FStilwell/0_Flicker_Fusion_Threshold/Eagle Files/Flicker_Fusion_schematic-white.PNG

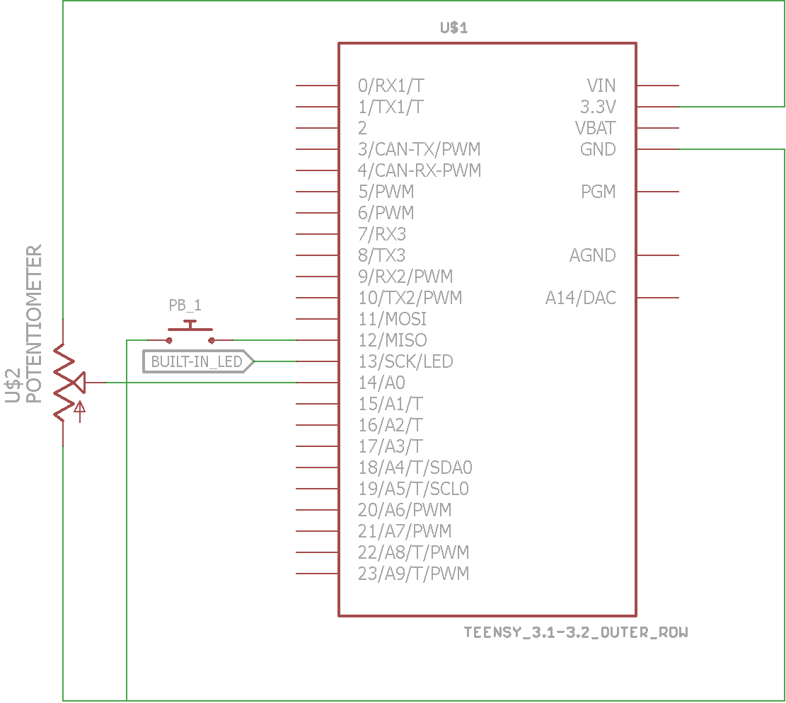
Eagle Files/Flicker_Fusion_schematic-white.PNG
