FStilwell/0_Flicker_Fusion_Threshold/Eagle Files/Flicker_Fusion_schematic.PNG

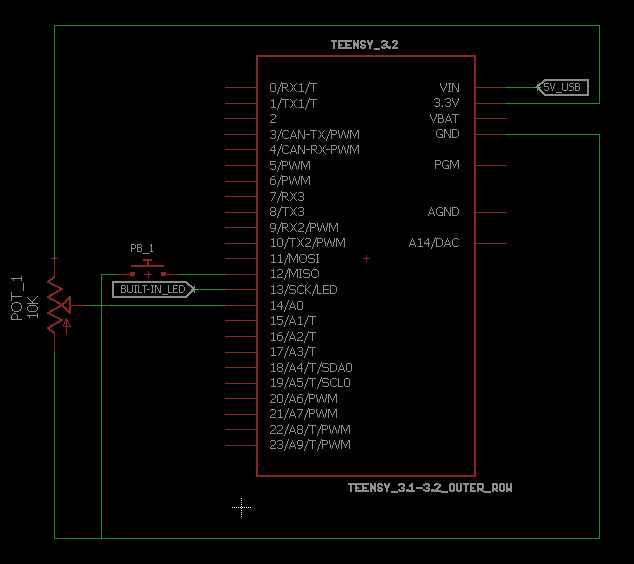
Eagle Files/Flicker_Fusion_schematic.PNG
