FStilwell/0_Flicker_Fusion_Threshold/Project_media/Images/Maximum_single_pin_current.PNG

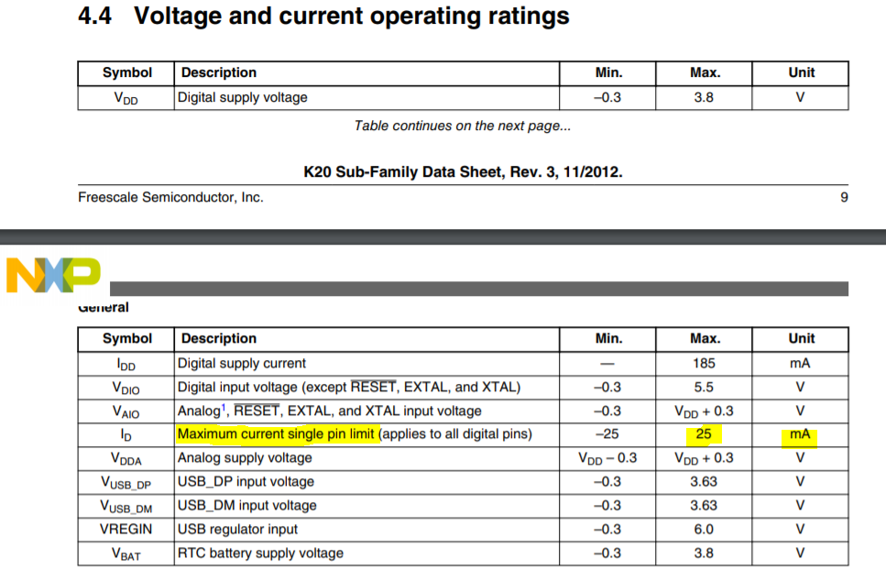
Project_media/Images/Maximum_single_pin_current.PNG
