FStilwell/0_Flicker_Fusion_Threshold/Project_media/Images/Teensy_3.2_pinout.jpg

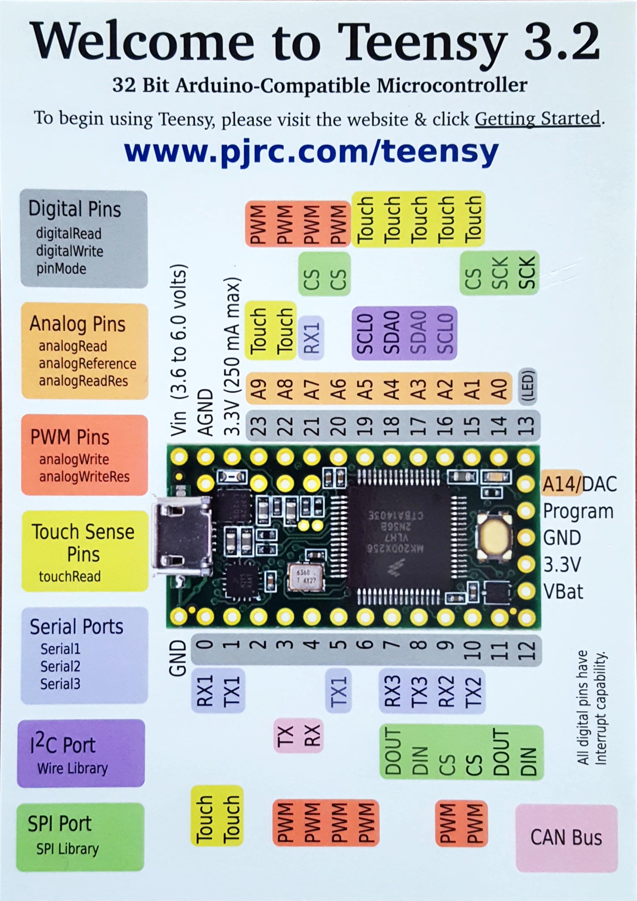
Project_media/Images/Teensy_3.2_pinout.jpg
