FStilwell/0_Flicker_Fusion_Threshold/Eagle Files/Flicker_Fusion.sch

## EAGLE design Eagle Files/Flicker_Fusion.sch (2020-05-09)

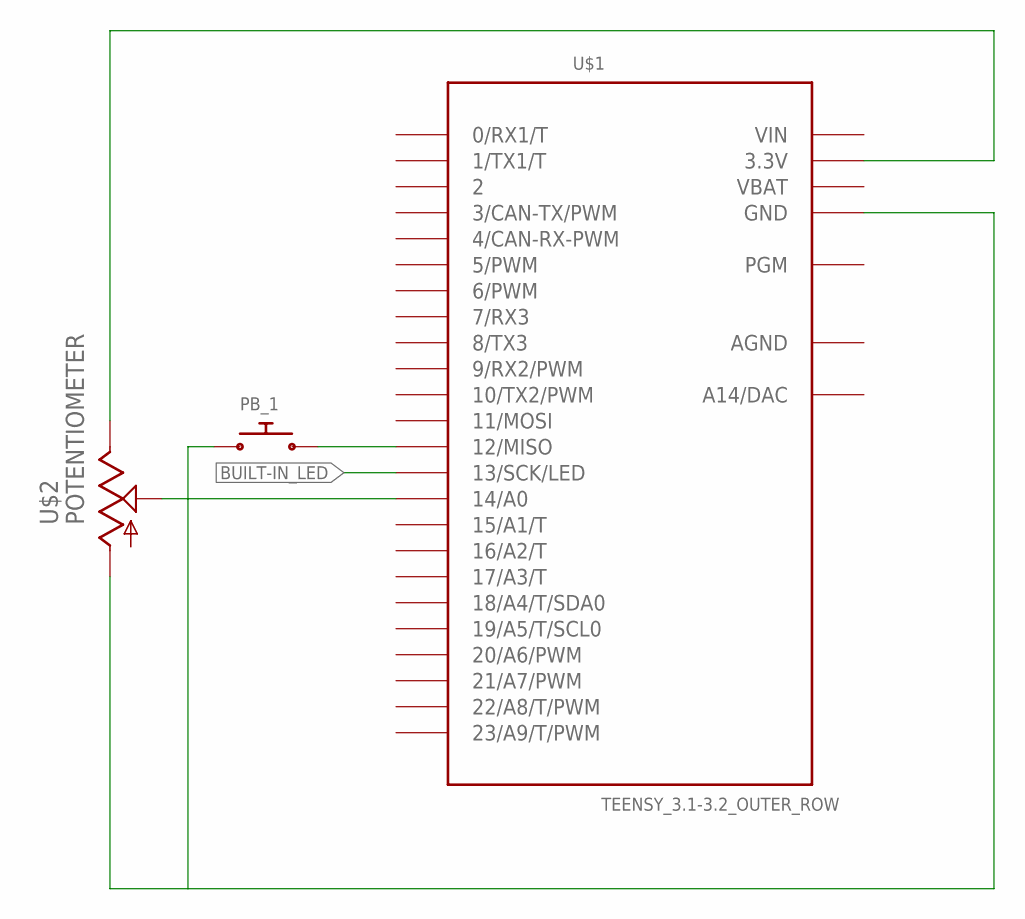
[picture p14: schematic Flicker_Fusion.sch]

Parts:
PB_1: PUSH_BUTTON_RCTNG; PB_DIP_RCTNG_3-WIDE
U$1: TEENSY_3.1-3.2_OUTER_ROW; TEENSY_3.0-3.2&LC_OUTER_ROW
U$2: POTENTIOMETER

Connections:
BUILT-IN_LED: U$1.13 (13/SCK/LED)
unnamed: PB_1.2, U$1.12 (12/MISO)
unnamed: PB_1.1, U$1.GND, U$2.+ (-)
unnamed: U$1.3.3V, U$2.- (+)
unnamed: U$1.14/A0, U$2.DATA
