FStilwell/0_Flicker_Fusion_Threshold/Project_media/Results/Flicker_Fusion_Threshold_Timing_Results.pptx

## Flicker Fusion Threshold Timing Results

Embedded Systems 2020

## Plotter at 25.24Hz, 100sps

Full Plot

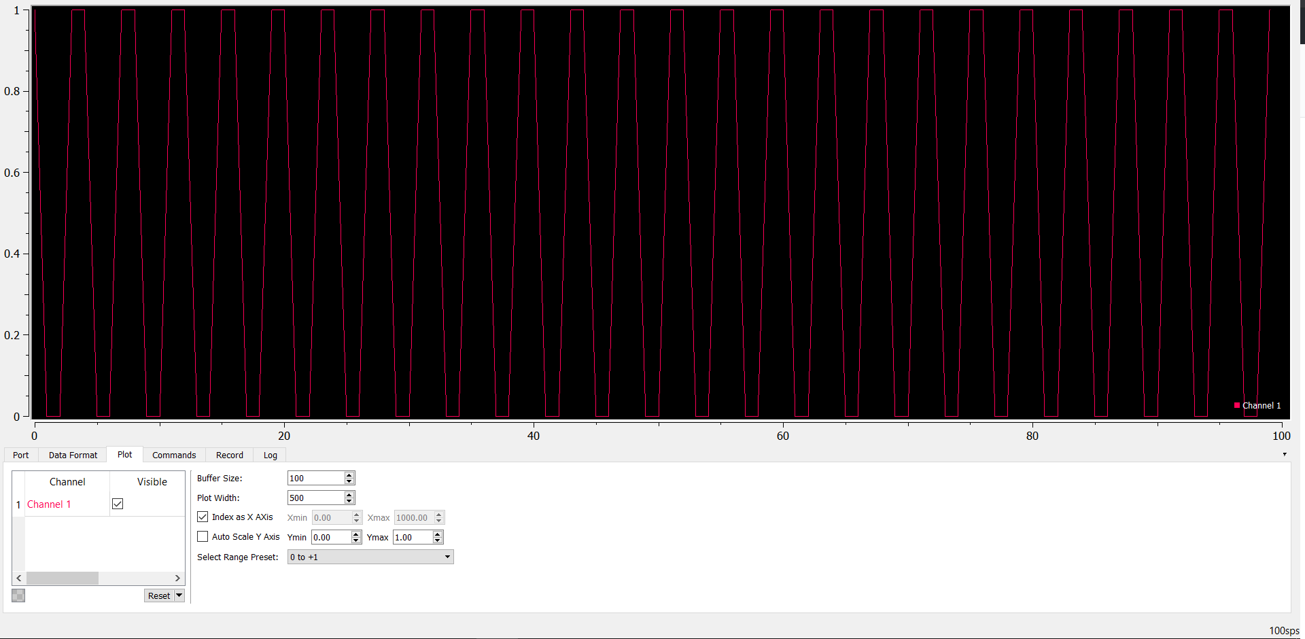
[picture p15: figure]

## Plotter at 25.24Hz, 100sps

Zoomed Plot

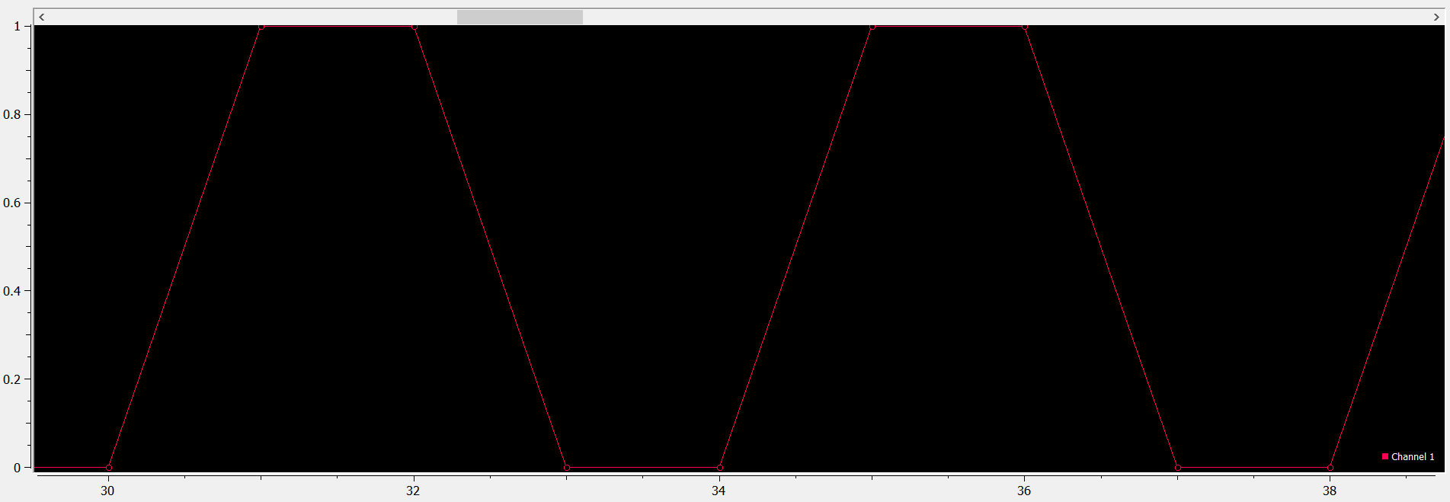
[picture p16: figure]

## Plotter at 57.22Hz, 229sps

Zoomed Plot

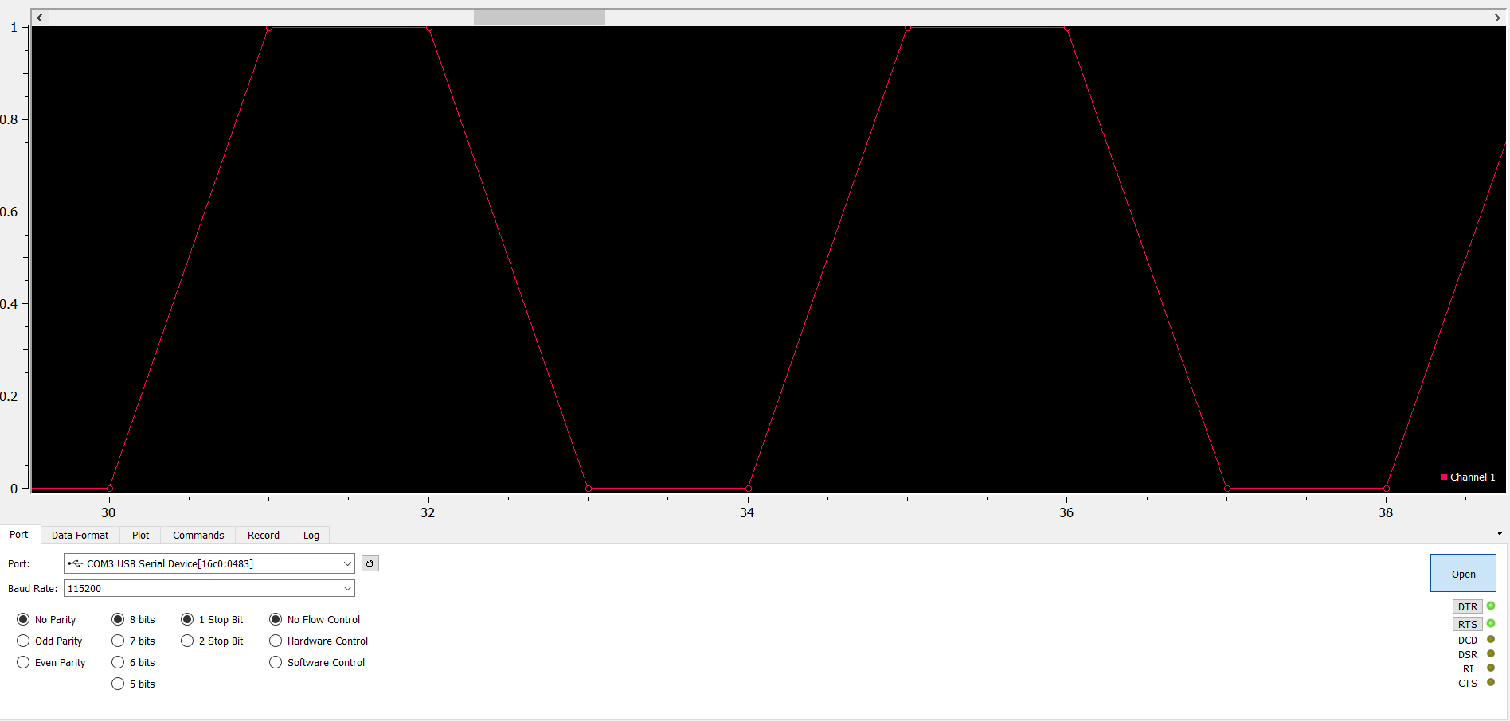
[picture p17: figure]
