FStilwell/0_Flicker_Fusion_Threshold/(commit log)

2020-05-07 Removed project - added by mistake
    [main.cpp]
2020-05-07 Added new project due to issues with include path
    [main.cpp]
2020-05-07 Working button with interrupt
2020-05-08 Full program with elapsed time printout
2020-05-09 Added Eagle Schematic
    [Flicker_Fusion.sch]
2020-05-09 Added LED datasheet
2020-05-10 Updated eagle schematic
2020-05-10 Added external interrupt test
2020-05-10 results powerpoint
2020-05-10 Removed bugged Project folder
    [main.cpp]
